antelliJ/LoRaPuck/assets/AntelliJ.png

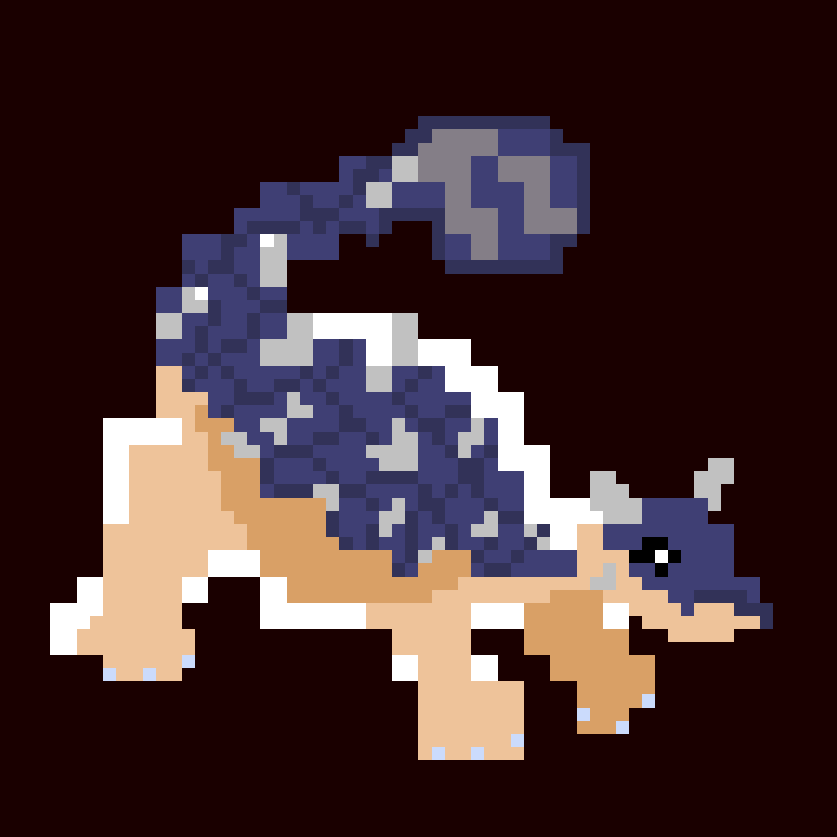
assets/AntelliJ.png
