antelliJ/LoRaPuck/BOM.csv

Item | Qty | Supplier | Cost/item | Total Cost | link
PCB | 1 | JLCPCB | $56.71 | $56.71 | https://cart.jlcpcb.com/quote
Estimated total shipping | 1 |  |  | $1.50
