antelliJ/LoRaPuck/3d models/editable/PCBPuckEnclosure.FCStd

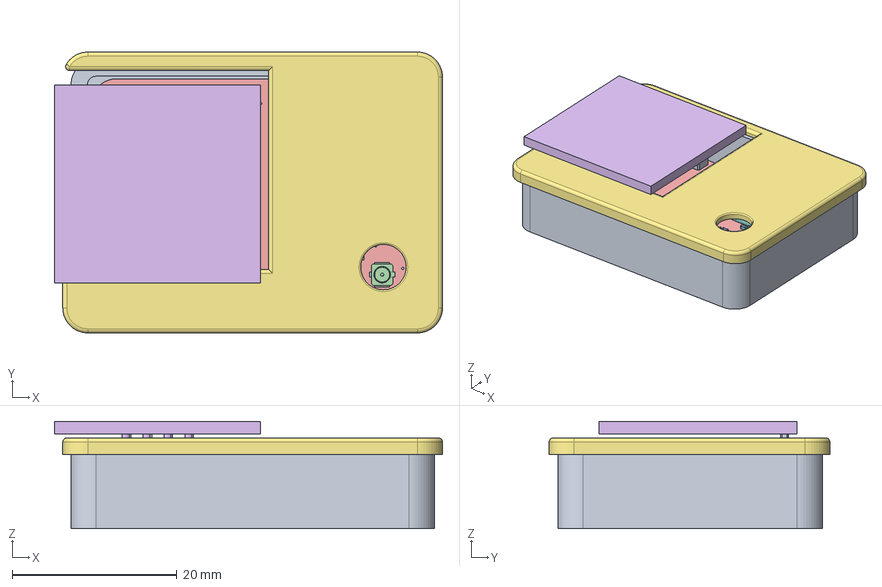
[picture p2: CAD file, 2026-11-08]
3d models/editable/PCBPuckEnclosure.FCStd
47.1 x 34.1 x 13.0 mm
Enclosure Bottom
SOT-363_SC-70-6
C_0402_1005Metric
C_0402_1005Metric002
R_0603_1608Metric
C_0402_1005Metric004
C_0402_1005Metric006
L_0402_1005Metric
PinHeader_1x04_P254mm_Vertical
C_0402_1005Metric008
L_0402_1005Metric002
C_0402_1005Metric010
L_0402_1005Metric004
Crystal_SMD_3225-4Pin_3.2x2.5mm
C_0603_1608Metric
QFN-24-1EP_4x4mm_Pitch0.5mm
L_0402_1005Metric006
C_0402_1005Metric012
C_0402_1005Metric014
U.FL_Hirose_U.FL-R-SMT-1_Vertical
L_0402_1005Metric008
C_0402_1005Metric016
C_0402_1005Metric018
C_0402_1005Metric020
C_0402_1005Metric022
C_0402_1005Metric024
C_0402_1005Metric026
C_0603_1608Metric002
LoRaPuck_PCB
Screen
Enclosure Top
