antelliJ/LoRaPuck/3d models/LoRaPuckPCB.step

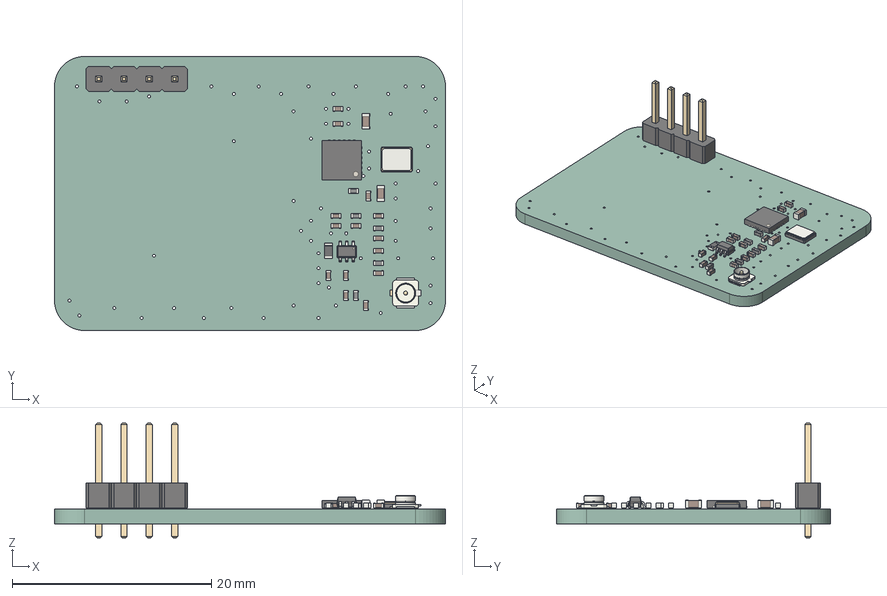
[picture p3: CAD file, 2026-11-08]
3d models/LoRaPuckPCB.step
39.2 x 27.5 x 11.5 mm
SOT-363_SC-70-6
C_0402_1005Metric x 14
R_0603_1608Metric
L_0402_1005Metric x 5
PinHeader_1x04_P254mm_Vertical
Crystal_SMD_3225-4Pin_3.2x2.5mm
C_0603_1608Metric x 2
QFN-24-1EP_4x4mm_Pitch0.5mm
U.FL_Hirose_U.FL-R-SMT-1_Vertical
LoRaPuck_PCB
