antelliJ/LoRaPuck/3d models/printable/PCBPuckEnclosure-Enclosure Bottom.3mf

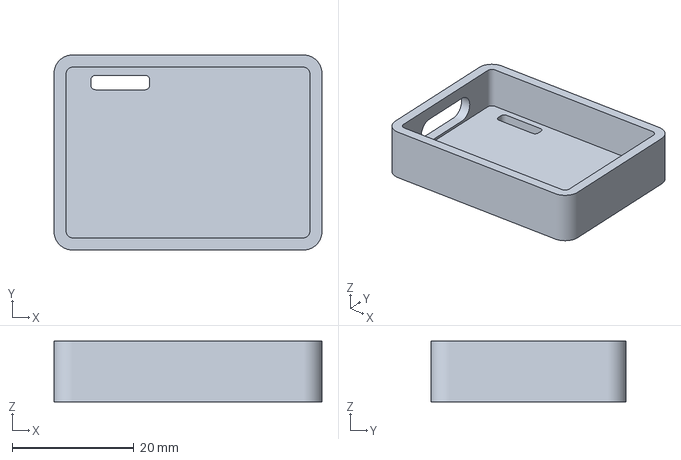
[picture p4: CAD file, 2026-11-08]
3d models/printable/PCBPuckEnclosure-Enclosure Bottom.3mf
44.1 x 32.1 x 10.0 mm
