antelliJ/LoRaPuck/3d models/printable/PCBPuckEnclosure-Enclosure Top.3mf

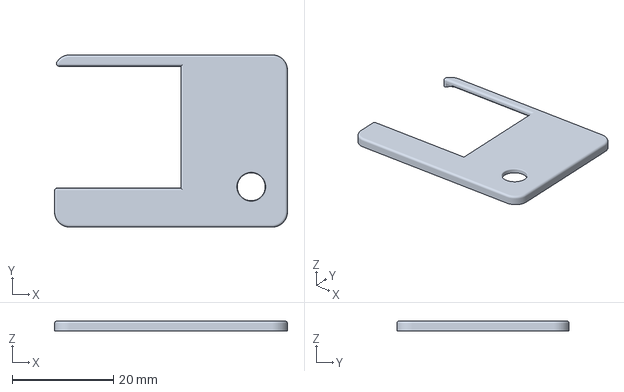
[picture p5: CAD file, 2026-11-08]
3d models/printable/PCBPuckEnclosure-Enclosure Top.3mf
46.1 x 34.1 x 2.00 mm
