antelliJ/LoRaPuck/LoRaPuckPCB/LoRaPuck.kicad_pcb

## KiCad design LoRaPuckPCB/LoRaPuck.kicad_pcb (2026-11-08)

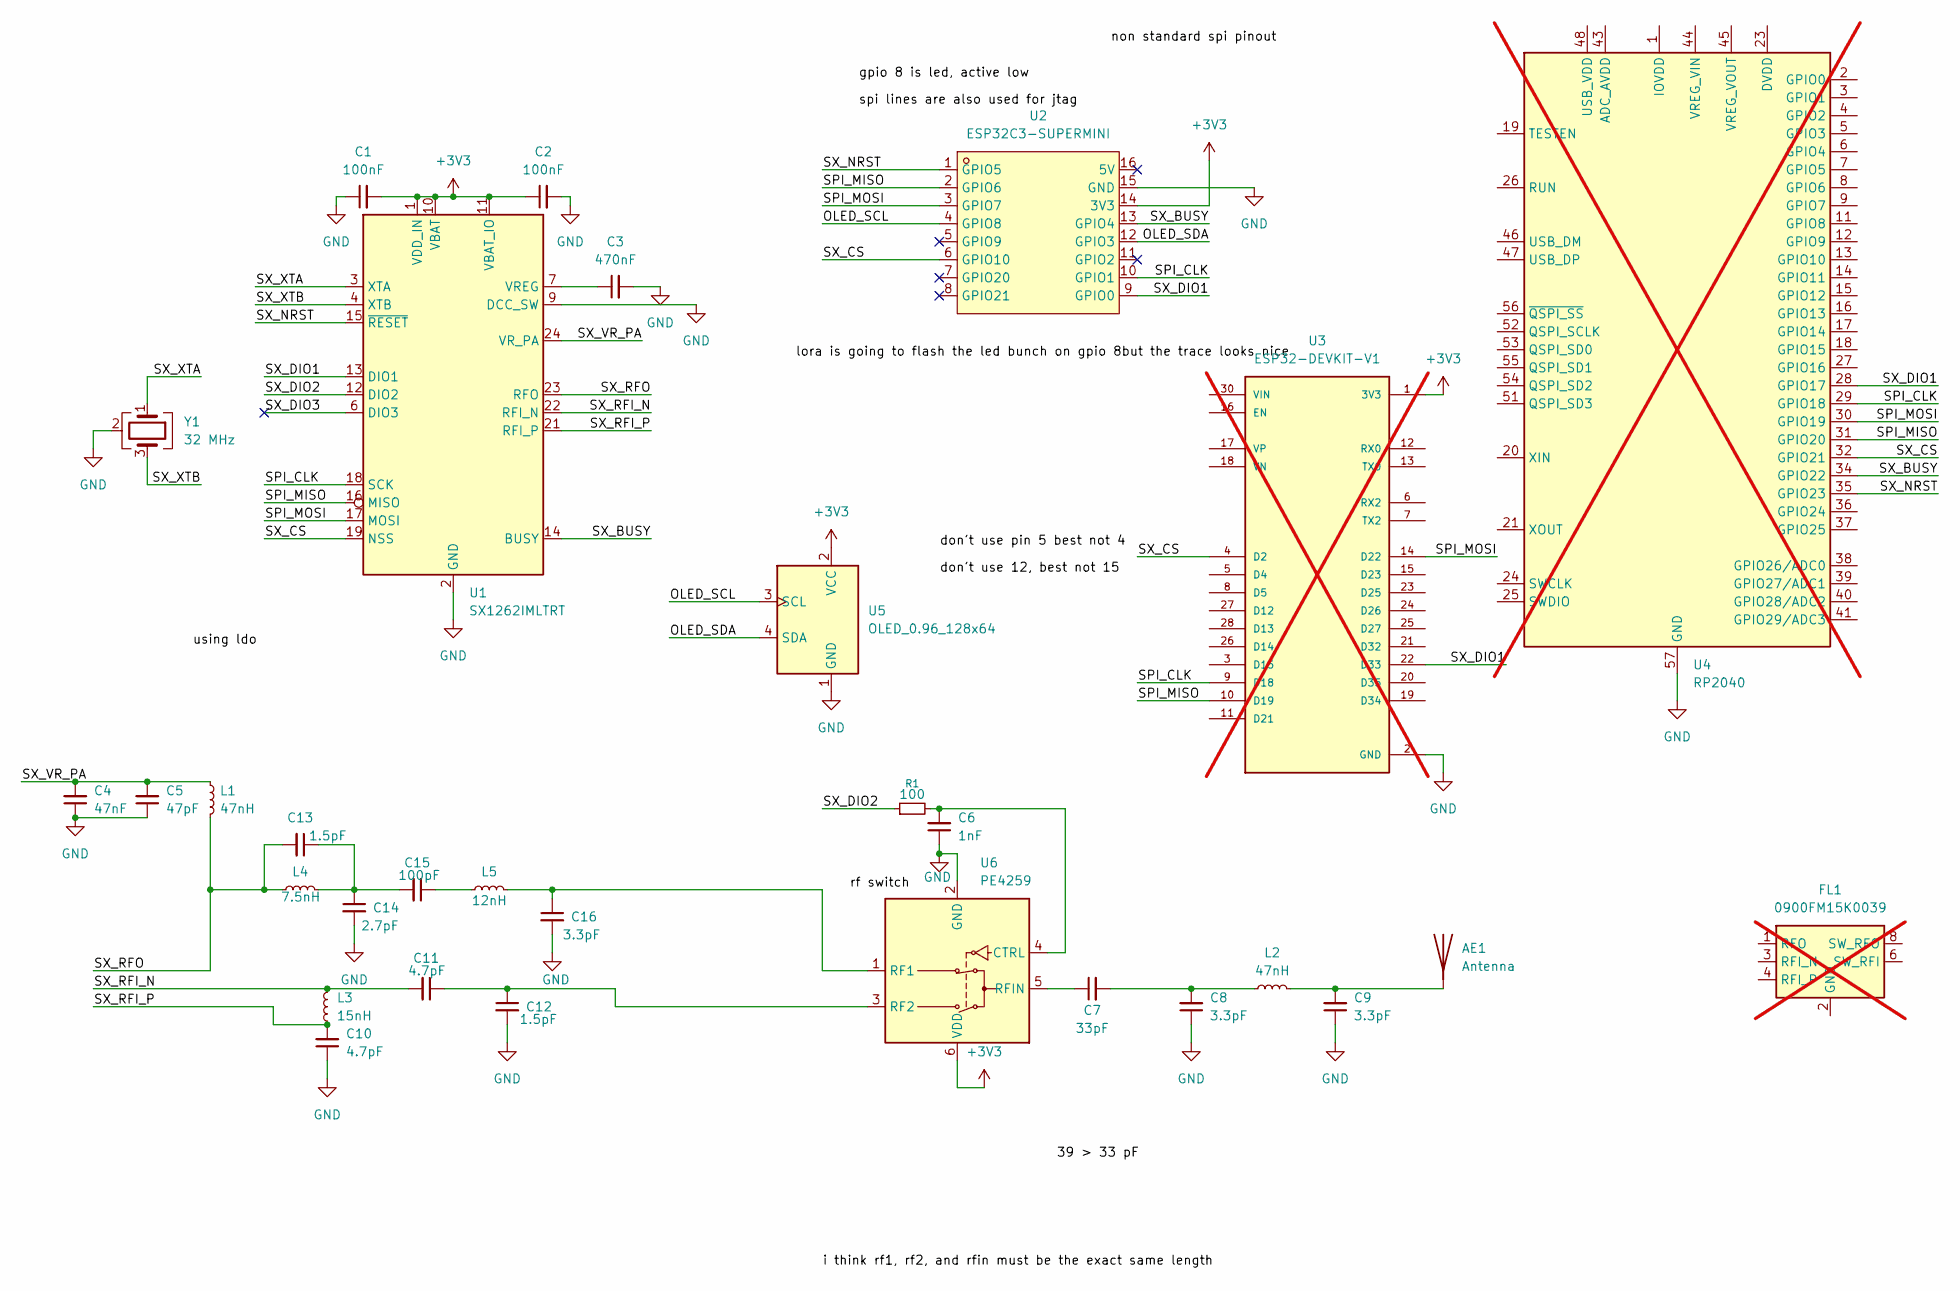
[picture p6: schematic LoRaPuck.kicad_sch]

Parts:
AE1: Antenna; U.FL_Hirose_U.FL-R-SMT-1_Vertical
C1, C2: 100nF; C_0402_1005Metric
C3: 470nF; C_0603_1608Metric
C4: 47nF; C_0603_1608Metric
C5: 47pF; C_0402_1005Metric
C6: 1nF; C_0402_1005Metric
C7: 33pF; C_0402_1005Metric
C8, C9, C16: 3.3pF; C_0402_1005Metric
C10, C11: 4.7pF; C_0402_1005Metric
C12, C13: 1.5pF; C_0402_1005Metric
C14: 2.7pF; C_0402_1005Metric
C15: 100pF; C_0402_1005Metric
FL1: 0900FM15K0039; Balun_Johanson_0900FM15K0039; not fitted
L1, L2: 47nH; L_0402_1005Metric
L3: 15nH; L_0402_1005Metric
L4: 7.5nH; L_0402_1005Metric
L5: 12nH; L_0402_1005Metric
R1: 100; R_0603_1608Metric
U1: SX1262IMLTRT; QFN-24-1EP_4x4mm_P0.5mm_EP2.6x2.6mm
U2: ESP32C3-SUPERMINI; COMM-SMD_16P-L22.5-W18.0-P2.54-TL; MPN ESP32C3-SuperMini; LCSC Part C9900147397
U3: ESP32-DEVKIT-V1; MODULE_ESP32_DEVKIT_V1; PARTREV N/A; not fitted
U4: RP2040; QFN-56-1EP_7x7mm_P0.4mm_EP3.2x3.2mm; not fitted
U5: OLED_0.96_128x64; PinHeader_1x04_P2.54mm_Vertical
U6: PE4259; SOT-363_SC-70-6
Y1: 32 MHz; Crystal_SMD_3225-4Pin_3.2x2.5mm

Connections:
+3V3: C1.2, C2.1, U1.1 (VDD_IN), U1.10 (VBAT), U1.11 (VBAT_IO), U2.14 (3V3), U3.1 (3V3), U5.2 (VCC), U6.6 (VDD)
/OLED_SCL: U2.4 (GPIO8), U5.3 (SCL)
/OLED_SDA: U2.12 (GPIO3), U5.4 (SDA)
/SPI_CLK: U1.18 (SCK), U2.10 (GPIO1), U3.9 (D18), U4.29 (GPIO18)
/SPI_MISO: U1.16 (MISO), U2.2 (GPIO6), U3.10 (D19), U4.31 (GPIO20)
/SPI_MOSI: U1.17 (MOSI), U2.3 (GPIO7), U3.14 (D22), U4.30 (GPIO19)
/SX_BUSY: U1.14 (BUSY), U2.13 (GPIO4), U4.34 (GPIO22)
/SX_CS: U1.19 (NSS), U2.6 (GPIO10), U3.4 (D2), U4.32 (GPIO21)
/SX_DIO1: U1.13 (DIO1), U2.9 (GPIO0), U3.22 (D33), U4.28 (GPIO17)
/SX_DIO2: R1.1, U1.12 (DIO2)
/SX_DIO3: U1.6 (DIO3)
/SX_NRST: U1.15 (~RESET), U2.1 (GPIO5), U4.35 (GPIO23)
/SX_RFI_N: C11.2, L3.2, U1.22 (RFI_N)
/SX_RFI_P: C10.2, L3.1, U1.21 (RFI_P)
/SX_RFO: C13.2, L1.2, L4.1, U1.23 (RFO)
/SX_VR_PA: C4.2, C5.2, L1.1, U1.24 (VR_PA)
/SX_XTA: U1.3 (XTA), Y1.1
/SX_XTB: U1.4 (XTB), Y1.3
GND: C1.1, C2.2, C3.2, C4.1, C5.1, C6.1, C8.1, C9.1, C10.1, C12.2, C14.2, C16.2, U1.2 (GND), U1.5 (GND), U1.8 (GND), U1.9 (DCC_SW), U1.20 (GND), U1.25 (GND), U2.15 (GND), U3.2 (GND), U3.29 (GND), U4.57 (GND), U5.1 (GND), U6.2 (GND), Y1.2 (G), Y1.4 (G)
unnamed: AE1.1 (A_1), C9.2, L2.2
unnamed: C7.2, C8.2, L2.1
unnamed: C13.1, C14.1, C15.2, L4.2
unnamed: C15.1, L5.1
unnamed: FL1.2 (GND), FL1.5 (GND), FL1.7 (GND), FL1.9 (GND), FL1.10 (GND)
unnamed: C3.1, U1.7 (VREG)
unnamed: U4.1 (IOVDD), U4.10 (IOVDD), U4.22 (IOVDD), U4.33 (IOVDD), U4.42 (IOVDD), U4.49 (IOVDD)
unnamed: U4.23 (DVDD), U4.50 (DVDD)
unnamed: C6.2, R1.2, U6.4 (CTRL)
unnamed: C16.1, L5.2, U6.1 (RF1)
unnamed: C11.1, C12.1, U6.3 (RF2)
unnamed: C7.1, U6.5 (RFIN)

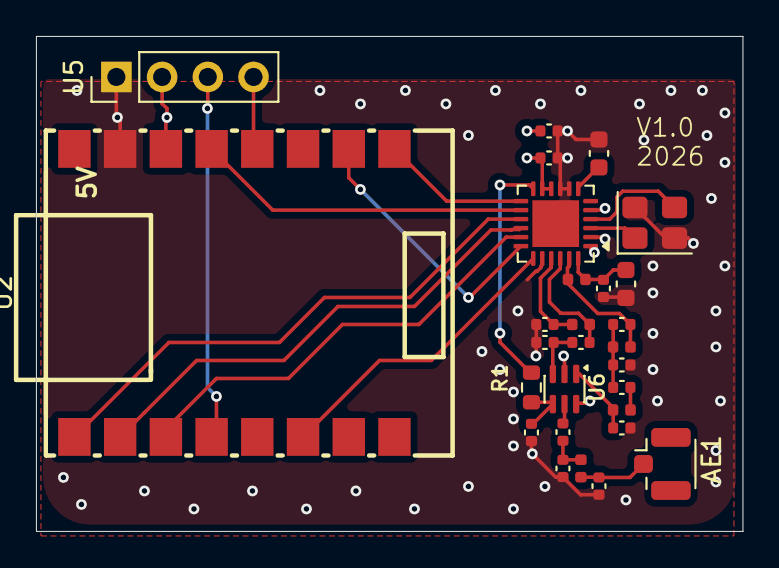
[picture p7: board LoRaPuck.kicad_pcb from above]

Board: 4 copper layers, 39.2 x 27.5 mm, 28 parts (0 on the bottom side), 27 nets.
