antelliJ/LoRaPuck/JOURNAL.md

# LoRa puck module: devlog

<!-- Generated by Half Life from project oxba013is2xj7i4vdq615q5s. Edits here are overwritten on the next sync. -->
<!-- Generated: 2026-11-08T23:59:27.777Z -->

> [!NOTE]
> This devlog is mirrored from [Half Life](https://halflife.hackclub.com) ([open the project](https://halflife.hackclub.com/projects/oxba013is2xj7i4vdq615q5s)). Editing it here will not change the platform's copy, and the next sync overwrites this file.

> using an esp32-c3 supermini and SX1262 radio module, I've made a portable node that has status updates on the oled screen. It connects primarily through bluetooth to a MeshCore client

| Week | Tier | Hours logged | Entries |
| --- | --- | --- | --- |
| Week 5 | Tier 2 | 17.91h | 5 |

## Contents

1. [2026-11-05: I started work on the schematic for the device, reading up on datasheets and figuring out the particular RF purposes for the different components](#2026-11-05-i-started-work-on-the-schematic-for-the-device-re)
2. [2026-11-06: Looking back on what the progress I made before, maybe choosing footprints that make the copper pads EXTRA thick isn't that great for all the high frequency work that the board is meant to deal with..](#2026-11-06-looking-back-on-what-the-progress-i-made-before-m)
3. [2026-11-06: From last time I have routed the PCB and rotated the LoRa module to be as accessible as possible. I've learned about via fencing to encapsulate some of the RF stuff,](#2026-11-06-from-last-time-i-have-routed-the-pcb-and-rotated-)
4. [2026-11-08: Got to looking at firmware and the actual availability of the components I want to use.](#2026-11-08-got-to-looking-at-firmware-and-the-actual-availab)
5. [2026-11-08: I started cleaning up the PCB form all the silkscreen designators and the values since they were cluttering the limited amount of space that I had available.](#2026-11-08-i-started-cleaning-up-the-pcb-form-all-the-silksc)

## Design

### 2026-11-05: I started work on the schematic for the device, reading up on datasheets and figuring out the particular RF purposes for the different components

**2.62h**

I started work on the schematic for the device, reading up on datasheets and figuring out the particular RF purposes for the different components

I decided against the dc-dc converter and for the LDO on the sx1262 since I'll likely just have powered wired directly through usb, and it requires more consideration on particular routing.  The added complexity for a little extra efficiency seemed a bit above my skill level

I put 3 MCUs on the schematic file since I was still a little unsure on which one I wanted to use





[Timelapse](https://lookout.hackclub.com/api/media/d2431823-c552-4182-ad24-d2b22ef19da7/video.mp4)

### 2026-11-06: Looking back on what the progress I made before, maybe choosing footprints that make the copper pads EXTRA thick isn't that great for all the high frequency work that the board is meant to deal with..

**2.52h**

Looking back on what the progress I made before, maybe choosing footprints that make the copper pads EXTRA thick isn't that great for all the high frequency work that the board is meant to deal with...

Finding out that there exists RF components / ICs that do a lot of the heavy lifting really lifted my spirits after seeing what the actual internals are supposed to do. In fact according to Michael Ossmann its reccomended to use the most integrated components, so I'll listen to someone who has a clue as to what they're doing.



I think I'm set on using the ESP32-C3 that I have, and I'm not sure how well it is configured for this type of TF project, but considering it has decent range on its wifi I'll hope that there's a ferrite bead or something that keeps it optimized.

[Timelapse](https://lookout.hackclub.com/api/media/9c844c3a-4869-44b3-ba30-2fc1ec20171d/video.mp4)

### 2026-11-06: From last time I have routed the PCB and rotated the LoRa module to be as accessible as possible. I've learned about via fencing to encapsulate some of the RF stuff,

**2.87h**

From last time I have routed the PCB and rotated the LoRa module to be as accessible as possible. I've learned about via fencing to encapsulate some of the RF stuff,
I'm thinking of including an oled screen next to the esp32 for added information about connecting things, right now it is just headers on the edge of the board, and they can be connected if desired



[Timelapse](https://lookout.hackclub.com/api/media/5e1af3d5-e29e-4b94-8674-daaa16e0720e/video.mp4)

### 2026-11-08: Got to looking at firmware and the actual availability of the components I want to use.

**4.37h**

Got to looking at firmware and the actual availability of the components I want to use.
I found out the LCSC has a shortage on the filter I wanted to use so I have to redesign the board with its discrete parts.
I converted a lot of the 0402 footprint components to 0603 since it would be cheaper from JLCPCB's assembly

I'm trying to create a new variant that meshcore can support for this project
I copied the repository from their github and updated it to my needs, but I think there is still work to do for makign it work properly with the PlatformIO toolchain

[Timelapse](https://lookout.hackclub.com/api/media/4cd9905d-4abc-455a-b229-4fad3a4fd74c/video.mp4)

### 2026-11-08: I started cleaning up the PCB form all the silkscreen designators and the values since they were cluttering the limited amount of space that I had available.

**5.53h**

I started cleaning up the PCB form all the silkscreen designators and the values since they were cluttering the limited amount of space that I had available.


I finally got the firmware to actually build, now whether it will work with real hardware, who knows.

I designed a simple small enclosure, which I'm hoping can keep the dust out. I opened up a spot for the antenna to go through, and allowed a little overhang on the top so the oled screen could have a bit of support and isn't solely dependent on the solder joints for stability.



[Timelapse](https://lookout.hackclub.com/api/media/aab3c133-fb01-4a1e-b359-1565b7b79b8f/video.mp4)
