antelliJ/LoRaPuck/Code/MeshCore-main/variants/antelliPuck/target.cpp

// antelliPuck/target.cpp
#include <Arduino.h>
#include "target.h"

AntelliPuckBoard board;

#if defined(P_LORA_SCLK)
  static SPIClass spi;
  RADIO_CLASS radio = new Module(P_LORA_NSS, P_LORA_DIO_1, P_LORA_RESET, P_LORA_BUSY, spi);
#else
  RADIO_CLASS radio = new Module(P_LORA_NSS, P_LORA_DIO_1, P_LORA_RESET, P_LORA_BUSY);
#endif

WRAPPER_CLASS radio_driver(radio, board);

ESP32RTCClock fallback_clock;
AutoDiscoverRTCClock rtc_clock(fallback_clock);

#if ENV_INCLUDE_GPS
  #include <helpers/sensors/MicroNMEALocationProvider.h>
  MicroNMEALocationProvider nmea = MicroNMEALocationProvider(Serial1, &rtc_clock);
  EnvironmentSensorManager sensors = EnvironmentSensorManager(nmea);
#else
  EnvironmentSensorManager sensors;
#endif

#ifdef DISPLAY_CLASS
  DISPLAY_CLASS display(NULL);
#endif

bool radio_init() {
  fallback_clock.begin();
  rtc_clock.begin(Wire);
  
#if defined(P_LORA_SCLK)
  spi.begin(P_LORA_SCLK, P_LORA_MISO, P_LORA_MOSI);
  return radio.std_init(&spi);
#else
  return radio.std_init();
#endif
}

mesh::LocalIdentity radio_new_identity() {
  RadioNoiseListener rng(radio);
  return mesh::LocalIdentity(&rng);  // create new random identity
}
