antelliJ/LoRaPuck/Code/MeshCore-main/variants/antelliPuck/target.h

// antelliPuck/target.h
#pragma once

#define RADIOLIB_STATIC_ONLY 1
#include <RadioLib.h>
#include <helpers/radiolib/RadioLibWrappers.h>
#include <AntelliPuckBoard.h>
#include <helpers/radiolib/CustomSX1262Wrapper.h>
#include <helpers/AutoDiscoverRTCClock.h>
// #include <helpers/SensorManager.h>
#include <helpers/sensors/EnvironmentSensorManager.h>
#ifdef DISPLAY_CLASS
#ifdef AntelliPuck_OLED
  #include <helpers/ui/SSD1306Display.h>
#endif
#ifdef HELTEC_LORA_V4_OLED
    #include <helpers/ui/SSD1306Display.h>
#endif
#endif
extern AntelliPuckBoard board;
extern WRAPPER_CLASS radio_driver;
extern AutoDiscoverRTCClock rtc_clock;
extern EnvironmentSensorManager sensors;

#ifdef DISPLAY_CLASS
  extern DISPLAY_CLASS display;
#endif

bool radio_init();
mesh::LocalIdentity radio_new_identity();
