antelliJ/LoRaPuck/(commit log)

2026-11-05 First commit, has schematic
    [LoRaPuck.kicad_pcb, LoRaPuck.kicad_sch]
2026-11-07 making schematic RF friendly maybe
    [LoRaPuck.kicad_pcb, LoRaPuck.kicad_sch]
2026-11-08 Included meshcore firmware and improved routing
    [BOM.xlsx, LoRaPuck.kicad_pcb, LoRaPuck.kicad_sch]
2026-11-08 Cleaned up code and made sure it actually compiles, started work on 3d
    [BOM.xlsx, LoRaPuck.kicad_pcb, LoRaPuckPCB.step, PCBPuckEnclosure-Enclosure Bottom.3mf, PCBPuckEnclosure-Enclosure Top.3mf, PCBPuckEnclosure.FCStd]
2026-11-08 Improved the README
    [BOM.xlsx]
2026-11-08 Update README with schematic and CAD model images
    Added schematic and CAD model images to README.
2026-11-08 AI declaration
    [LoRaPuck.kicad_pcb]
2026-11-09 Sync LoRa puck module from Half Life
    [BOM.csv]
